3couch-alt/Work/3d-print-pricing.xlsx

Sheet: Price Calculator
3D Print Price Calculator
One row per item. Fill in the yellow cells: name, version, grams and print hours are needed; the lighter yellow cells are optional - leave them blank to use the defaults on the Settings tab.
Rows 5-8 are examples - type over them with your own items. Get grams and print time from Bambu Studio after slicing (for multicolor, use the total including flushed filament).
Item | Version | Filament (g) | Print time (hrs) | Cleanup (min) | Painting (hrs) | Paint supplies ($) | Hardware / extras ($) | Packaging ($) | Markup override | Material ($) | Machine time ($) | Failure buffer ($) | Labor ($) | Supplies & packaging ($) | Total cost ($) | Markup used | Target price before fees ($) | LIST PRICE ($) | Selling fees ($) | Your profit ($) | Profit per print hour ($) | Notes
Example - Oni mask, single color | Single color | 200 | 8.0 | 30 |  |  | $1.50 |  |  | $4.00 | $4.00 | $0.80 | $10.00 | $3.50 | $22.30 | 2.00x | $44.60 | $50.00 | $5.20 | $22.50 | $2.81 | Strap $1.50; packaging uses the default
Example - Oni mask, hand-painted | Painted | 230 | 15.0 | 30 | 3.0 |  | $1.50 |  |  | $4.60 | $7.50 | $1.21 | $70.00 | $8.50 | $91.81 | 1.50x | $137.72 | $153.00 | $14.98 | $46.20 | $3.08 | Paint supplies use the default
Example - Keychain | Single color | 8 | 0.5 | 5 |  |  | $0.30 | $0.50 | 3.00x | $0.16 | $0.25 | $0.04 | $1.67 | $0.80 | $2.92 | 3.00x | $8.75 | $11.00 | $1.50 | $6.59 | $13.17 | Key ring $0.30; higher markup for a small item
Example - Desk organizer | Single color | 245 | 9.0 | 20 |  |  |  | $3.00 |  | $4.90 | $4.50 | $0.94 | $6.67 | $3.00 | $20.01 | 2.00x | $40.01 | $45.00 | $4.72 | $20.27 | $2.25 | Bigger box for shipping

Sheet: Settings
Settings - shared costs and defaults for every item
Yellow cells with blue text are yours to change. Gray cells calculate automatically. Defaults are used when an item's own cell on the Price Calculator is left blank.
Setting | Value | What it means / where the number came from
Filament spool price ($) | $20.00 | What you pay for one spool. Starting estimate - change it to your real price.
Spool weight (g) | 1000 | Most spools are 1 kg (1000 g).
Filament cost per gram ($) | $0.020 | Calculated: spool price / spool weight.
Machine rate ($ per print hour) | $0.50 | Covers electricity (only a few cents an hour on a P2S), nozzle and plate wear, and paying off the printer. Common rule-of-thumb estimate.
Failure buffer (%) | 10.0% | Extra added to material + machine cost to cover prints that fail.
Your labor rate ($/hr) | $20.00 | What you pay yourself for hands-on work (cleanup and painting).
Default cleanup time (minutes) | 15 | Used when an item's Cleanup cell is blank: removing supports, sanding, assembly, packing.
Default paint supplies, painted items ($) | $5.00 | Used when a 'Painted' item's Paint supplies cell is blank: primer, paint and clear coat.
Default packaging ($) | $2.00 | Used when an item's Packaging cell is blank: box or mailer, padding, label.
Selling fee (%) | 9.5% | Etsy (US, as of 2025): 6.5% transaction fee + 3% payment processing. Offsite Ads sales cost an extra 12-15%. Set to 0% for cash or in-person sales. Check current fees: https://www.etsy.com/legal/fees/
Fixed fee per sale ($) | $0.45 | Etsy (US, as of 2025): $0.20 listing fee + $0.25 payment processing. Set to 0 for in-person sales.
Round list price up to nearest ($) | $1.00 | Keeps prices tidy, e.g. $49.78 becomes $50. Use 5 to round to the next $5, or 0 for no rounding.
Markup by version
Version | Markup | Why this multiplier
Single color | 2.00x | One filament, no paint. Starting point; compare with what similar items sell for.
Multicolor | 2.50x | Printed in several colors with the AMS - looks finished without paint, so it sells at a premium.
Painted | 1.50x | Lower multiplier because your painting hours are already paid at your labor rate.
Keep the version names as they are - the calculator's dropdown uses them. Any item can override its markup in the 'Markup override' column.
The markups were picked against 3D-printed Oni masks on Etsy (unpainted ~$41-65, hand-painted ~$129-175; etsy.com/market/3d_printed_oni_mask, checked Oct 2026). Small, cheap items usually need a higher markup - see the keychain example.

Sheet: How to Use
How to use this calculator
1. Open the Settings tab and change the yellow cells to match your real costs (spool price, your hourly rate, fees) and your usual cleanup time and packaging.
2. On the Price Calculator tab, add one row per item: name, version (dropdown), and grams and print time from Bambu Studio.
3. Fill in the lighter yellow cells only where an item is different: its own cleanup time, painting hours, paint supplies, hardware (straps, magnets, key rings), packaging, or a different markup. Blank cells use the defaults on the Settings tab; type 0 for none.
4. The green LIST PRICE column is what to list it for. It already covers Etsy's fees.
5. Compare that price with similar items on Etsy. If yours is much higher, lower the markup (per item with Markup override, or per version on the Settings tab) or find ways to cut print or hands-on time.
6. Use 'Profit per print hour' to see which items make the best use of your printer.
Tips
- Time yourself on your first few painted pieces and use real hours - painting is usually the biggest cost.
- Small, cheap prints (keychains, magnets) usually need a markup of 3x or more, because your hands-on time and fees are a big share of the price.
- Selling in person or with cash? Set the selling fee % and fixed fee to 0 on the Settings tab.
- 'Your profit' is extra money after paying yourself your labor rate for cleanup and painting.
- Red numbers in the profit columns mean that item loses money at the current settings.
- Check the model's license allows selling prints before you list it.
Cell colors
Yellow with blue text = needed input. Lighter yellow = optional input (blank uses the defaults). Green = the price to list. White/gray = calculated, don't type here.
