3couch-alt/Work/oni-mask-pricing.xlsx

Sheet: Price Calculator
Oni Mask Price Calculator
Fill in the yellow cells for each mask (name, version, grams, print hours, painting hours). Everything else calculates. Change shared costs on the Settings tab.
Rows 5-7 are examples - type over them with your own masks. Get grams and print time from Bambu Studio after slicing (for multicolor, use the total including flushed filament).
Mask name | Version | Filament (g) | Print time (hrs) | Painting time (hrs) | Material ($) | Machine time ($) | Failure buffer ($) | Cleanup labor ($) | Painting ($) | Strap & packaging ($) | Total cost ($) | Markup | Target price before fees ($) | LIST PRICE ($) | Selling fees ($) | Your profit ($) | Profit per print hour ($) | Notes
Example - Oni (8 hr print) | Unpainted | 200 | 8.0 |  | $4.00 | $4.00 | $0.80 | $10.00 | $0.00 | $3.50 | $22.30 | 2.00x | $44.60 | $50.00 | $5.20 | $22.50 | $2.81 | Etsy unpainted: ~$41-65
Example - Oni multicolor (12 hr) | Multicolor | 260 | 12.0 |  | $5.20 | $6.00 | $1.12 | $10.00 | $0.00 | $3.50 | $25.82 | 2.50x | $64.55 | $75.00 | $7.58 | $41.60 | $3.47 | Grams include AMS flush
Example - Oni hand-painted (15 hr) | Painted | 230 | 15.0 | 3.0 | $4.60 | $7.50 | $1.21 | $10.00 | $65.00 | $3.50 | $91.81 | 1.50x | $137.72 | $155.00 | $15.18 | $48.02 | $3.20 | Etsy painted: ~$129-175

Sheet: Settings
Settings - shared costs used for every mask
Yellow cells with blue text are yours to change. Gray cells calculate automatically.
Setting | Value | What it means / where the number came from
Filament spool price ($) | $20.00 | What you pay for one spool of PLA. Starting estimate - change it to your real price.
Spool weight (g) | 1000 | Most PLA spools are 1 kg (1000 g).
Filament cost per gram ($) | $0.020 | Calculated: spool price / spool weight.
Machine rate ($ per print hour) | $0.50 | Covers electricity (only a few cents an hour on a P2S), nozzle and plate wear, and paying off the printer. Common rule-of-thumb estimate.
Failure buffer (%) | 10.0% | Extra added to material + machine cost to cover prints that fail.
Your labor rate ($/hr) | $20.00 | What you pay yourself for hands-on work (cleanup and painting).
Cleanup time per mask (minutes) | 30 | Removing supports, light sanding, attaching the strap, packing.
Paint supplies per painted mask ($) | $5.00 | Your share of primer, acrylic paint and clear coat used on one mask. Only added to 'Painted' masks.
Strap / eye mesh per mask ($) | $1.50 | Elastic strap, eye mesh or other wearable hardware. Set to 0 for display-only masks.
Packaging per mask ($) | $2.00 | Box, tissue or bubble wrap, label.
Selling fee (%) | 9.5% | Etsy (US, as of 2025): 6.5% transaction fee + 3% payment processing. Offsite Ads sales cost an extra 12-15%. Set to 0% for cash or in-person sales. Check current fees: https://www.etsy.com/legal/fees/
Fixed fee per sale ($) | $0.45 | Etsy (US, as of 2025): $0.20 listing fee + $0.25 payment processing. Set to 0 for in-person sales.
Round list price up to nearest ($) | $5.00 | Keeps prices tidy, e.g. $62.10 becomes $65. Use 1 for whole dollars.
Markup by version
Version | Markup | Why this multiplier
Unpainted | 2.00x | Single-color print. Similar 3D-printed Oni masks on Etsy list for about $41-65.
Multicolor | 2.50x | Printed in several colors with the AMS - looks finished without paint, so it sells at a premium.
Painted | 1.50x | Lower multiplier because your painting hours are already paid at your labor rate. Similar hand-painted masks on Etsy list for about $129-175.
Keep the version names as they are - the calculator's dropdown uses them.
Etsy price ranges: etsy.com/market/3d_printed_oni_mask and etsy.com/market/oni_wearable_mask, checked Oct 2026.

Sheet: How to Use
How to use this calculator
1. Open the Settings tab and change the yellow cells to match your real costs (spool price, your hourly rate, packaging, fees).
2. On the Price Calculator tab, add one row per mask: name, version (dropdown), grams and print time from Bambu Studio, and painting hours if painted.
3. The green LIST PRICE column is what to list it for. It already covers Etsy's fees.
4. Compare that price with similar masks on Etsy. If yours is much higher, lower the markup on the Settings tab or find ways to cut print or painting time.
5. Use 'Profit per print hour' to see which masks make the best use of your printer.
Tips
- Time yourself on your first few painted masks and use real hours - painting is the biggest cost.
- Selling in person or with cash? Set the selling fee % and fixed fee to 0 on the Settings tab.
- 'Your profit' is extra money after paying yourself your labor rate for cleanup and painting.
- Red numbers in the profit columns mean that mask loses money at the current settings.
- Check the model's license allows selling prints before you list it.
Cell colors
Yellow with blue text = your input. Green = the price to list. White/gray = calculated, don't type here.
