3couch-alt/Work/3d-print-sales-tracker.xlsx

Sheet: Sales Log
Sales Log
One row per order. Yellow = fill in (date, item, price, platform). Lighter yellow = optional. Green-headed columns calculate automatically.
Rows 5-8 are examples - delete them when you add your first real sale. Refunded or cancelled orders stay in the log (grayed out) but don't count on the Summary.
Date | Item | Qty | Price each ($) | Shipping charged ($) | Discount ($) | Platform | Shipping cost ($) | Status | Revenue ($) | Fees ($) | Cost to make ($) | Profit ($) | Margin | Order # | Customer | Cost per item override ($) | Fee override ($) | Notes | Items (helper)
2026-10-02 | Oni mask, single color | 1 | $50.00 | $6.50 |  | Etsy | $5.80 | Shipped | $56.50 | $5.82 | $12.30 | $32.58 | 57.7% | EX-1001 |  |  |  | Example - delete this row | 1
2026-10-04 | Keychain | 3 | $11.00 |  |  | In person |  | Delivered | $33.00 | $0.00 | $3.75 | $29.25 | 88.6% |  |  |  |  | Example - delete this row | 3
2026-10-09 | Oni mask, hand-painted |  | $153.00 |  | $15.00 | Etsy | $9.20 | Paid | $138.00 | $13.56 | $21.81 | $93.43 | 67.7% | EX-1002 |  |  |  | Example: free shipping and a $15 coupon - delete this row | 1
2026-10-12 | Desk organizer | 1 | $45.00 |  |  | Etsy | $6.00 | Refunded | $45.00 | $4.72 | $13.34 | $20.93 | 46.5% | EX-1003 |  |  |  | Example: refunded, so it's left out of the Summary - delete this row | 1

Sheet: Summary
Sales Summary
Updates as you add sales. Refunded and cancelled orders are left out. Profit includes your pay for your time, because Cost to make doesn't count it.
Year | 2026 | This year by default - type a year (e.g. 2027) to see a different one.
Month | Orders | Items sold | Revenue | Fees | Shipping costs | Cost to make | Profit | Margin
46023 | 0 | 0 | $0.00 | $0.00 | $0.00 | $0.00 | $0.00
46054 | 0 | 0 | $0.00 | $0.00 | $0.00 | $0.00 | $0.00
46082 | 0 | 0 | $0.00 | $0.00 | $0.00 | $0.00 | $0.00
46113 | 0 | 0 | $0.00 | $0.00 | $0.00 | $0.00 | $0.00
46143 | 0 | 0 | $0.00 | $0.00 | $0.00 | $0.00 | $0.00
46174 | 0 | 0 | $0.00 | $0.00 | $0.00 | $0.00 | $0.00
46204 | 0 | 0 | $0.00 | $0.00 | $0.00 | $0.00 | $0.00
46235 | 0 | 0 | $0.00 | $0.00 | $0.00 | $0.00 | $0.00
46266 | 0 | 0 | $0.00 | $0.00 | $0.00 | $0.00 | $0.00
46296 | 3 | 5 | $227.50 | $19.38 | $15.00 | $37.86 | $155.26 | 68.2%
46327 | 0 | 0 | $0.00 | $0.00 | $0.00 | $0.00 | $0.00
46357 | 0 | 0 | $0.00 | $0.00 | $0.00 | $0.00 | $0.00
Year total | 3 | 5 | $227.50 | $19.38 | $15.00 | $37.86 | $155.26 | 68.2%
All time | 3 | 5 | $227.50 | $19.38 | $15.00 | $37.86 | $155.26 | 68.2%
By platform (selected year)
Platform | Orders | Items sold | Revenue | Fees | Profit | Margin
Etsy | 2 | 2 | $194.50 | $19.38 | $126.01 | 64.8%
Facebook Marketplace | 0 | 0 | $0.00 | $0.00 | $0.00
eBay | 0 | 0 | $0.00 | $0.00 | $0.00
In person | 1 | 3 | $33.00 | $0.00 | $29.25 | 88.6%
Other | 0 | 0 | $0.00 | $0.00 | $0.00
By item (selected year) - items on the Products tab
Item | Orders | Items sold | Revenue | Fees | Profit | Margin
Oni mask, single color | 1 | 1 | $56.50 | $5.82 | $32.58 | 57.7%
Oni mask, hand-painted | 1 | 1 | $138.00 | $13.56 | $93.43 | 67.7%
Keychain | 1 | 3 | $33.00 | $0.00 | $29.25 | 88.6%
Desk organizer | 0 | 0 | $0.00 | $0.00 | $0.00

Sheet: Products
Products
List what you sell. The Sales Log's Item dropdown uses these names, and each sale's cost fills in from 'Cost per item' automatically.
Cost per item = what one costs you in filament, machine time, supplies, hardware and packaging - not your time. From the 3D Print Price Calculator: Total cost minus Labor.
Item | Version | List price ($) | Cost per item ($) | Notes
Oni mask, single color | Single color | $50.00 | $12.30 | Price calculator: total cost $22.30 minus labor $10.00
Oni mask, hand-painted | Painted | $153.00 | $21.81 | Price calculator: total cost $91.81 minus labor $70.00
Keychain | Single color | $11.00 | $1.25 | Price calculator: total cost $2.92 minus labor $1.67
Desk organizer | Single color | $45.00 | $13.34 | Price calculator: total cost $20.01 minus labor $6.67

Sheet: Settings
Settings - selling platforms and their fees
Fees are estimated as: total order x Fee % + Fixed fee, but never less than the Minimum fee. Yellow cells are yours to change; add more platforms in the empty rows.
Fee rates change - check your platform's current fees. For an exact number on any order, type it into 'Fee override' on the Sales Log.
Platform | Fee (%) | Fixed fee per order ($) | Minimum fee ($) | Notes / source
Etsy | 9.5% | $0.45 | $0.00 | 6.5% transaction + 3% payment processing, plus $0.20 listing + $0.25 processing (US, as of 2025). Offsite Ads sales cost an extra 12-15% - use Fee override for those. https://www.etsy.com/legal/fees/
Facebook Marketplace | 10.0% | $0.00 | $0.80 | Shipped orders. Published rates disagree (5%-10%, minimum $0.40-$0.80) - check yours in Commerce Manager. Local pickup has no fee: use 'In person'. Source: underpriced.app/blog/facebook-marketplace-fees-2026
eBay | 13.6% | $0.40 | $0.00 | Most categories (2026): 13.6% of the total including shipping + $0.40 per order ($0.30 if $10 or less). Source: sellerfeecalc.com/ebay-fees/final-value-fee
In person | 0.0% | $0.00 | $0.00 | Cash. If you take cards (e.g. Square), put the card fee here.
Other | 0.0% | $0.00 | $0.00

Sheet: How to Use
How to use this sales tracker
1. Products tab: list what you sell, with what one costs you (filament, machine time, supplies, hardware, packaging - not your time). From the 3D Print Price Calculator, that's Total cost minus Labor.
2. Settings tab: check the fee rates for the places you sell, and add any others.
3. Sales Log: add one row per order - date, item (dropdown), price each and platform. Add qty, shipping charged, discount, shipping cost and status when they apply. Fees, cost to make and profit fill in by themselves.
4. For the exact fee on an order, copy it from your Etsy payment account into 'Fee override'. For a one-off cost (custom color, extra hardware), use 'Cost per item override'.
5. Mark refunds and cancellations in the Status column - they stay in the log but drop out of the totals.
6. Summary tab: monthly totals for the year in the yellow box, plus all-time totals and breakdowns by platform and by item.
Good to know
- Delete the example rows (marked 'Example' in Notes) before adding real sales.
- Don't include sales tax that Etsy or eBay collects for you - it isn't your money.
- Profit here is what's left for you after costs and fees, so it includes your pay for your time.
- Keep this file and your platform statements for taxes. This isn't tax advice.
Cell colors
Yellow with blue text = fill in. Lighter yellow = optional. Gray with a green header = calculated, don't type there. Gray strikethrough rows = refunded or cancelled.
