3couch-alt/Work/desk-organizer/desk_organizer_one_plate.stl

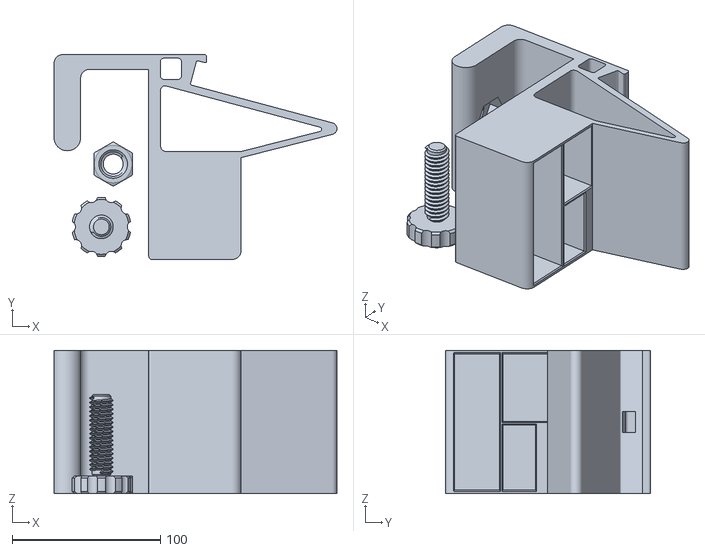
[picture p6: CAD file, 2026-10-06]
desk-organizer/desk_organizer_one_plate.stl
191.2 x 138.4 x 96.8
