3couch-alt/Work/(commit log)

2026-10-05 Add Oni mask pricing calculator spreadsheet
    Calculates cost and a suggested list price per mask from filament grams,
    print hours and painting hours, with shared costs, Etsy fees and
    per-version markups on a Settings tab.
    Claude-Session: https://claude.ai/code/session_01E1abf5Ra2toge5Pouqh2Lt
    [oni-mask-pricing.xlsx]
2026-10-06 Add clamp-on desk organizer model
    Parametric OpenSCAD model (BOSL2 threads) of a desk-edge organizer with a
    keys cup, wallet pocket and tilted phone slot with a cable hole. Includes
    print-oriented STLs for left- and right-side mounting, a printed clamp
    screw and nut, preview renders and print/assembly notes.
    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
    [clamp_nut.stl, clamp_screw.stl, desk_organizer.scad, organizer_body_LEFT_side.stl, organizer_body_RIGHT_side.stl]
2026-10-06 Desk organizer: add phone stand for Galaxy S23 Ultra, one-plate STLs
    Replace the deep phone slot with a front-facing stand (65 degree
    backrest, lip, strut, USB-C cable hole) that holds an S23 Ultra in a
    case in portrait or landscape. Export body, screw and nut together as a
    single print-ready STL per desk side, and taper the unused underside to
    save filament.
    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
    [clamp_nut.stl, clamp_screw.stl, desk_organizer.scad, desk_organizer_LEFT_side_one_plate.stl, desk_organizer_RIGHT_side_one_plate.stl, organizer_body_LEFT_side.stl, organizer_body_RIGHT_side.stl]
2026-10-06 Desk organizer: phone faces across the desk, stand sits on the desk
    Turn the phone stand 90 degrees so the screen faces across the desk
    (right when mounted on the left side, left on the right side) and move
    it onto the clamp's top jaw. The design is now symmetric, so a single
    one-plate STL fits either side. The body prints standing on its end so
    the clamp and stand profiles lie in each layer; the lower jaw is full
    width and the nut pocket prints flat-side up so no supports are needed.
    The USB-C cable drops into a side-to-side tunnel under the ledge.
    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
    [desk_organizer.scad, desk_organizer_LEFT_side_one_plate.stl, desk_organizer_RIGHT_side_one_plate.stl, desk_organizer_one_plate.stl]
2026-10-06 Desk organizer: phone faces outward at the desk edge, pockets behind it
    Rework the layout for viewing the phone from beside the desk: the stand
    sits at the desk edge with the screen facing outward, leaning back 15
    degrees for viewing from about desk height. The keys cup, a new Fire TV
    remote slot and the wallet pocket sit behind it on the desk, starting
    behind where the phone's top leans so nothing collides with it. Still
    one symmetric, support-free STL with the screw and nut on the same
    plate.
    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
    [desk_organizer.scad, desk_organizer_one_plate.stl]
2026-10-06 Desk organizer: add a remote pocket beside the phone
    Add a Fire TV remote pocket at the outer edge beside the phone stand so
    it can be reached from beside the desk. The old slot behind the phone
    stays as a spare. The body now prints standing on the remote-pocket end
    so the clamp and stand profiles continue under it and nothing needs
    supports; the screw is centred on the longer clamp.
    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
    [desk_organizer.scad, desk_organizer_one_plate.stl]
2026-10-06 Desk organizer: move the remote back behind the phone
    Turn the side remote pocket off by default (side_pocket = false) so
    nothing sits beside the phone and it can be turned sideways; the slot
    behind the stand is the remote slot again. Add a sideways-phone preview
    and keep the side pocket available as an option.
    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
    [desk_organizer.scad, desk_organizer_one_plate.stl]
2026-10-06 Desk organizer: sleeker profile
    Rebuild the side profile as clean rounded outlines: a slim fin-shaped
    stand with a rounded tip and a smooth triangular window in place of
    the boxy backrest/lid/back-wall tower, a rounded clamp corner and jaw,
    a rolled top-back edge on the pocket block (wallet pocket widened so
    the opening stays the same), rounded lip and tunnel, and beveled pocket
    rims. Same holding layout, still one support-free plate.
    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
    [desk_organizer.scad, desk_organizer_one_plate.stl]
2026-10-06 Add general 3D print pricing calculator
    Generalize the Oni mask pricing sheet for any 3D print: an Item column,
    per-item cleanup time, paint supplies, hardware and packaging (blank uses
    the defaults on the Settings tab), an optional per-item markup override,
    generic version names, whole-dollar rounding, and four varied example
    rows.
    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
    [3d-print-pricing.xlsx]
2026-10-06 Add 3D print sales tracker spreadsheet
    Sales log (one row per order) with auto-calculated revenue, platform
    fees, cost to make, profit and margin; a Products tab that fills in
    each sale's cost; per-platform fee settings (Etsy, Facebook
    Marketplace, eBay, in person); and a Summary with monthly totals for a
    chosen year, all-time totals, and breakdowns by platform and item.
    Refunded and cancelled orders stay in the log but drop out of totals.
    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
    [3d-print-sales-tracker.xlsx]
